LinnesLab/HELPStat/HELPStat/Hardware/HELPStat_V2_BOM.xlsx

@LinnesLab ESP32-S3 Potentisotat Rev B |  |  |  |  |  |  |  |  |  |  | Total | $28.54
BOM # | Comment | Designator | Description | Mounting Type | Package | Manufacturer | Manufacturer Part Number | Supplier | Supplier Part Number | Price per unit | Quantity | Total
1 | ESP32-S3-WROOM-1-N8R8 | MCU | Bluetooth, WiFi 802.11b/g/n, Bluetooth v5.0 Transceiver Module 2.4GHz PCB Trace Surface Mount | SMD | 41-SMD Module | Espressif Systems | ESP32-S3-WROOM-1-N8R8 | Digi-Key | 1965-ESP32-S3-WROOM-1-N8R8CT-ND | $3.62 | 1 | $3.62
2 | 3.3V Regulator | LDO | Linear Voltage Regulator IC Positive Fixed 1 Output 600mA SOT-25 | SMD | SOT-25 | Diodes Incorporated | AP2112K-3.3TRG1 | Digi-Key | AP2112K-3.3TRG1DITR-ND | $0.35 | 1 | $0.35
3 | Micro USB | USB | USB - micro B USB 2.0 Receptacle Connector 5 Position Surface Mount, Right Angle | SMD | Flange, Horizontal | Amphenol FCI | 10118192-0001LF | Digi-Key | 609-4613-1-ND | $0.46 | 1 | $0.46
4 | PFET | Q1 | P-Channel 30 V 2.5A (Ta) 760mW (Ta) Surface Mount SOT-23-3 | SMD | SOT-23-3 | Diodes Incorporated | DMG2307LQ-7 | Digi-Key | 31-DMG2307LQ-7TR-ND | $0.37 | 1 | $0.37
5 | Schottky Diode | D1 | DIODE SCHOTTKY 23V 1A SOD323 | SMD | SOD-323 | STMicroelectronics | BAT20JFILM | Digi-Key | 497-3381-2-ND | $0.40 | 1 | $0.40
6 | Tiny Rectangular Button | RST, BOOT | Tactile Switch SPST-NO Top Actuated Surface Mount | SMD | Gull Wing | C&K Components | PTS830GM140 SMTR LFS | Digi-Key | CKN10587CT-ND | $0.67 | 2 | $1.34
7 | LiPo Charger / Monitor | IC1 | IC BATT CNTL LI-ION 1CEL SOT23-5 | SMD | SOT-23-5 | Microchip Technology | MCP73812T-420I/OT | Digi-Key | MCP73812T-420I/OTTR-ND | $0.73 | 1 | $0.73
8 | Green LED | PWR | Green 571nm LED Indication - Discrete 2V 0603 (1608 Metric) | SMD | 0603 | Lite-On Inc. | LTST-C191KGKT | Digi-Key | 160-1446-2-ND | $0.26 | 1 | $0.26
9 | Yellow LED | CHRG | Yellow 591nm LED Indication - Discrete 2.1V 0603 (1608 Metric) | SMD | 0603 | Lite-On Inc. | LTST-C190KSKT | Digi-Key | 160-1437-2-ND | $0.26 | 1 | $0.26
10 | 100k Resistor | R4 | 100 kOhms ±1% 0.1W, 1/10W Chip Resistor 0603 (1608 Metric) Automotive AEC-Q200 Thick Film | SMD | 0603 | Panasonic Electronic Components | ERJ-3EKF1003V | Digi-Key | P100KHTR-ND | $0.10 | 1 | $0.10
11 | 47k Resistor | R6, R7, R8, R9, R10, R11, R12, R13 | 47 kOhms ±5% 0.1W, 1/10W Chip Resistor 0402 (1005 Metric) Automotive AEC-Q200 Thick Film | SMD | 0402 | Panasonic Electronic Components | ERJ-2GEJ473X | Digi-Key | P47KJTR-ND | $0.10 | 8 | $0.80
12 | 10k Resistor | R1 | 10 kOhms ±1% 0.1W, 1/10W Chip Resistor 0402 (1005 Metric) Automotive AEC-Q200 Thick Film | SMD | 0402 | Panasonic Electronic Components | ERJ-2RKF1002X | Digi-Key | P10.0KLTR-ND | $0.10 | 1 | $0.10
13 | 4.7k Resistor | R2, R3, R5 | 4.7 kOhms ±1% 0.1W, 1/10W Chip Resistor 0402 (1005 Metric) Automotive AEC-Q200 Thick Film | SMD | 0402 | Panasonic Electronic Components | ERJ-2RKF4701X | Digi-Key | P4.70KLTR-ND | $0.10 | 3 | $0.30
14 | 10uF Capacitor | C1, C2, C3, C4, C5, C6, C17 | 10 µF ±20% 10V Ceramic Capacitor X5R 0402 (1005 Metric) | SMD | 0402 | Murata Electronics | GRM155R61A106ME11D | Digi-Key | 490-GRM155R61A106ME11DTR-ND | $0.13 | 7 | $0.91
15 | 4.7uF Capacitor | C11 | 4.7 µF ±20% 10V Ceramic Capacitor X5R 0402 (1005 Metric) | SMD | 0402 | Samsung Electro-Mechanics | CL05A475MP5NRNC | Digi-Key | 1276-1482-2-ND | $0.10 | 1 | $0.10
16 | 1uF Capacitor | C7 | 1 µF ±10% 25V Ceramic Capacitor X5R 0402 (1005 Metric) | SMD | 0402 | Murata Electronics | GRM155R61E105KA12D | Digi-Key | 490-10017-2-ND | $0.10 | 1 | $0.10
17 | 0.47uF Capacitor | C8, C9, C10, C12 | 0.47 µF ±10% 25V Ceramic Capacitor X5R 0402 (1005 Metric) | SMD | 0402 | TDK Corporation | C1005X5R1E474K050BB | Digi-Key | 445-8020-2-ND | $0.12 | 4 | $0.48
18 | 0.1uF Capacitor | C13, C14, C15, C16, C18, C19 | 0.1 µF ±10% 25V Ceramic Capacitor X5R 0402 (1005 Metric) | SMD | 0402 | Samsung Electro-Mechanics | CL05A104KA5NNNC | Digi-Key | 1276-1043-2-ND | $0.10 | 6 | $0.60
19 | AD5941 AFE | AD5941 | BIO-IMPEDANCE & ELECTROCHEMICAL | SMD | 48-Lead LFSCP | Analog Devices Inc. | AD5941BCPZ-RL7 | Digi-Key | 505-AD5941BCPZ-RL7TR-ND | $11.45 | 1 | $11.45
20 | MicroSD Card slot | SDCARD | 8 Position Card Connector Secure Digital - microSD™ Surface Mount, Right Angle Gold | SMD | SMD, Right angle | 3M | 2908-05WB-MG | Digi-Key | 3M5607TR-ND | $4.86 | 1 | $4.86
21 | JST Connector | LIPO1 | 2-pin, compact SMT JST Connector | SMD | SMD, Right angle | SparkFun | PRT-11641 | SparkFun | PRT-11641 | $0.95 | 1 | $0.95
