LinnesLab/HELPStat/(commit log)

2024-05-31 Add files via upload
    initial commit
    [HELPStat_V2.brd, HELPStat_V2.sch, HELPStat_V2_BOM.xlsx, PCBWayQuotedBOM_5Sets_2024-01-11.xls]
2024-06-11 added comments and fixed function inputs
    [AD594x_EIS_Demo.ino]
2024-06-11 Introducing basic BLE Functionality
    Implemented BLE based on EIS-LevenbergMarquardtAlgorithm work (see organization GitHub repo).
    TO-DO:
    * Finalize other BLE settings
    * Testing w/ Randle's cells, EIS samples, etc.
2024-06-12 Finish Implementing BLE
    Finished implementing BLE.
    Able to adjust:
    * Rct Estimate
    * Rs Estimate
    * Start Frequency
    * End Frequency
    * NumPoints
    * NumCycles
    * DAC Gain
    * External Gain
    * Rcal Value
    * Zero Voltage
    * Bias Voltage
    * Delay Seconds
    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
    [AD594x_EIS_Demo.ino]
2024-06-19 Fixed bug w/ HELPStatLib
    Found a bug in the HELPStatLib that prevented the push button to be used w/ the BLE start signal. Fixed this.
    [AD594x_EIS_Demo.ino, HELPStat.cpp, HELPStat.h]
2024-06-19 BLE Functionality for Each Sweep
    Firmware now sends Index, Frequency, Zreal, and Zimag for every measurement. Also added the Excel sheet listing each UUID, what parameter is associated with it, and what BLE characteristics are used (see software/Docs).
    [HELPStat BLE UUIDs.xlsx]
2024-06-19 Debugging the BLE Field Data
    Found that sending data after each sweep caused faulty measurements. Instead implemented this into the transmit_resistors function. Will have to continue testing tomorrow, but so far, it appears to send all Zreal and Zimag data after running an entire sample. Phone is about to die, so unable to continue testing until I get it charged up tomorrow.
2024-06-20 Bug Fix, Send Frequency, Real Impedence, and Imaginary Impedence Data
    Fixed the bug where sending data after each sweep messed w/ potentiostat timing and caused invalid measurements. Instead, send all impedence and frequency samples at the very end in the transmit_resistors function. Also renamed this to transmitResults since now sending all results (not just Rct/Rs).
    * Delete the BLE characteristic for index. This is not used nor needs to be present for the Android app.
    * Work w/ BLE_settings() function to deal w/ push button.
    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
    [AD594x_EIS_Demo.ino, HELPStat.cpp, HELPStat.h]
2024-06-20 Started Implementing XY Plot for Zreal/imag data
    Since still waiting for access to circuits lab for current draw test and still waiting on Android for BLE testing, decided to deal with data visualization. Managed to get project to use the androidplot library and was able to add an empty plot to the main layout. Need to figure out Kotlin code for the activity to actually add points to the plot.
2024-06-20 redrawNyquist
    Wrote a function called redrawNyquist. When called, it clears the graph and draws a new one based off current Zreal/Zimag values. Once BLE is working, this will be called twice:
    (1) when the start button is clicked. This just clears Zreal and Zimag, making the graph a clear plot.
    (2) when all of the BLE data is received. This will then draw the Nyquist plot for the most recent sample.
    NOTE: I am electing to clear at the beginning of a sample so that the user can more easily tell when a sample is running (clear) vs when a sample is finished (semicircle).
2024-06-21 BLE Scanning
    Now able to scan for a BLE device.
2024-06-21 BLE Scanning and Display
    Start & stop a scan, display results of scan to user. Added a filter that only looks for devices with name "HELPStat" to filter out any other device.
2024-06-24 Start Signal
    Can now signal the HELPStat PCB to start running a sample. Tested to ensure that we can run repeated samples w/o resetting the device.
2024-06-25 Fully Functional Prototype for Android App
    Android App is now fully functional. On startup, user loads an empty Nyquist plot.
    First, user must connect to the HELPStat PCB. This is done by: (1) hitting "Start BLE Scan", (2) wait until "HELPStat" appears, (3) hit "Stop BLE Scan", and (4) hitting "HELPStat."
    Once connected, the user can hit "Settings" to change settings. Typing a value into a textfield and then hitting the corresponding "Apply" button will update the corresponding setting. To exit settings, the user can hit "Home."
    Once ready, the user can hit "Start" to start a sample. Once the sample is complete, the values will display on the screen.
    * Modify the BLE Scan / Connec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
2024-06-26 Semi-AutoConnect for App
    On startup, if user clicks on "Connect", the device will automatically start & stop BLE scan before connecting to HELPStat. In previous versions, this was a 3-step process.
    Tried to have the app immediately connect on startup, but causes the app to crash if BLE is not enabled (instead of prompting the user to turn on bluetooth).
    Also did some color changes to make it look better. I don't think it really worked.
2024-06-26 Update Settings
    Fixed bug where settings "revert" if user closes and reopens setting page even though no changes were made to the PCB.
    Found bug: if you close the app, you have to restart the device in order for BLE devices to connect again (not entirely sure why)
2024-06-27 Fixed Reconnection Bug
    Not entirely sure how, but fixed the bug that prevents the user from reconnecting to HELPStat if they close and reopen the device. Probably an issue with the teardownConnection making it impossible to reconnect in the future.
2024-06-28 Bug Fixes, Bode Plot, Axis Titles
    * Fixed bug where app sometimes crashes when trying to redraw
    Found that app might try to refresh graph while receiving data, causing size mismatch error.
    * Adjusted the firmware library to also transmit the phase measurements.
    * Added functionality in app to receive the transmitted phase measurements and plot against log(f).
    * Added axis titles and managed to adjust positionings.
    [HELPStat.cpp, HELPStat.h]
2024-06-28 Excel Document w/ UUIDs
    Update
    [HELPStat BLE UUIDs.xlsx, HELPStat UUIDs.xlsx]
2024-07-01 "Error" Alert, Switched from Rads to Degs
    * "Error" Alert -> Noticed that if the estimate for Rct/Rs was too far off, the fitting algorithm would not calculate a value. To compensate for this, added an error box that would say tell the user the estimate was bad. Also would state what the first Zreal (Rs estimate) or what the last Zreal (Rct) value was as a suggestion for a better estimate.
    * Switched the phase diagram from rads to degs.
    * Minor clean-up of code.
    [HELPStat.cpp]
2024-07-02 Added Magnitude
    Updated firmware to transmit magnitude data
    Updated software to receive and display magnitude data
    Added some formatting to fix origin at (0,0) for Nyquist plot
    Formatting to have x-axis tick marks for Bode plots to be 1.0 (for decades)
    Set y-axis boundary of 0 for Bode magnitude plot.
    Updated APK release file.
    [HELPStat.cpp, HELPStat.h]
2024-07-03 Minor Clean-up of .ino file, adding licenses
    [HELPStat UUIDs.xlsx]
2024-07-12 Button Bug Fix
    Fixed bug where HELPStat would start running samples before being told to by button or BLE.
    Also, moved all curly braces in code to be after function declaration for consistency.
    [AD594x_EIS_Demo.ino, HELPStat.cpp]
2025-04-09 Update for esp32 v3.2 Library
    Arduino Library Manager upgraded ESP32 library to v3.2. Changed how String datatype was used. Updated to allow BLE functionality w/ updated firmware.
    TODO: Fix issue w/ SD card not mounting.
    [AD594x_EIS_Demo.ino, HELPStat.cpp, HELPStat.h, lma.cpp]
